TehoorMarjan/grannyclock/CAD/ClockV1/ClockV1Box.FCStd

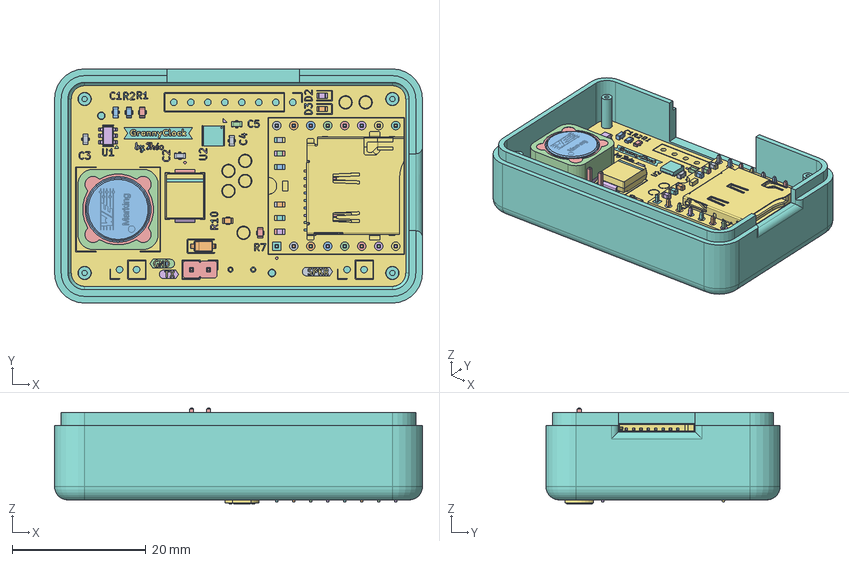
[picture p9: CAD file, 2025-05-12]
CAD/ClockV1/ClockV1Box.FCStd
55.0 x 35.0 x 14.3 mm
C_0603_1608Metric
LED_0603_1608Metric
R_0603_1608Metric
C_0603_1608Metric001
R_0603_1608Metric001
LED_0603_1608Metric001
DFR0299
DFR0300
DFR0301
DFR0302
DFR0303
DFR0304
DFR0305
DFR0306
DFR0307
DFR0308
DFR0309
DFR0310
DFR0311
DFR0312
DFR0313
DFR0314
DFR0315
DFR0316
DFR0317
DFR0318
DFR0319
DFR0320
DFR0321
DFR0322
DFR0323
DFR0324
DFR0325
DFR0326
DFR0327
DFR0328
DFR0329
DFR0330
DFR0331
DFR0332
DFR0333
DFR0334
DFR0335
DFR0336
DFR0337
DFR0338
DFR0339
DFR0340
DFR0341
DFR0342
DFR0343
DFR0344
DFR0345
DFR0346
DFR0347
DFR0348
DFR0349
DFR0350
DFR0351
DFR0352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
