TehoorMarjan/grannyclock/CAD/DualAABatteryBox/DualAABatteryBox.step

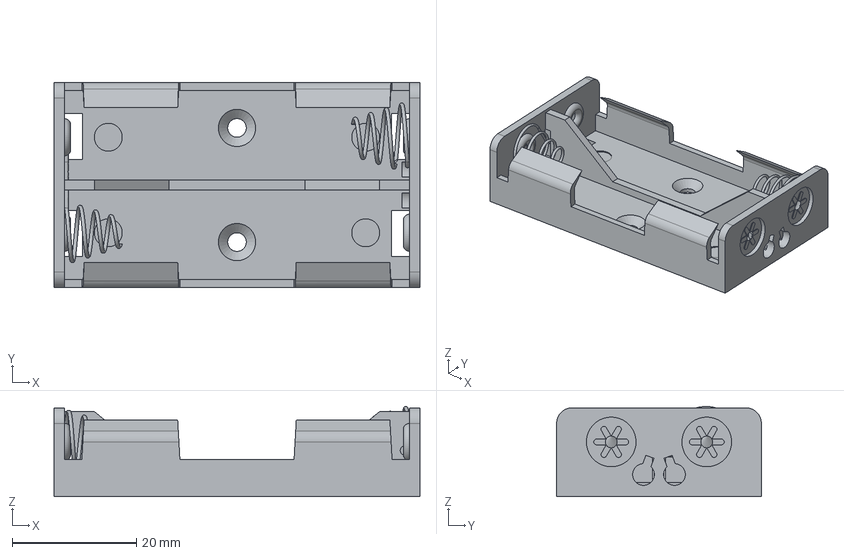
[picture p10: CAD file, 2025-05-19]
CAD/DualAABatteryBox/DualAABatteryBox.step
59.0 x 33.0 x 14.5 mm
