TehoorMarjan/grannyclock/CAD/HD-1688_Inner/HD-1688_Inner.step

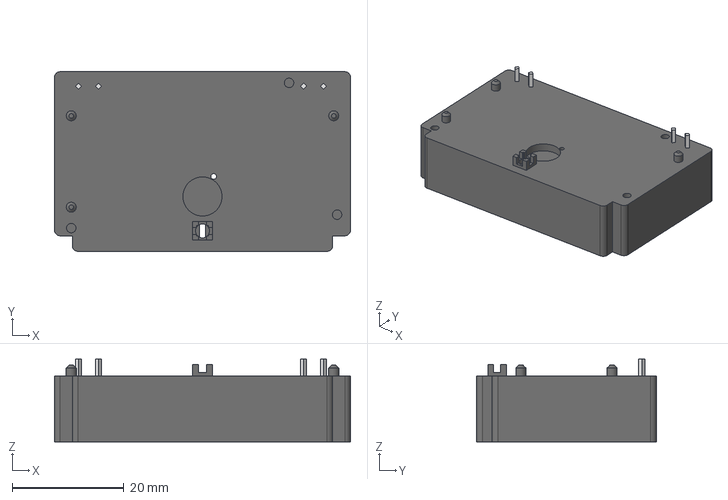
[picture p11: CAD file, 2025-05-23]
CAD/HD-1688_Inner/HD-1688_Inner.step
53.0 x 32.2 x 14.8 mm
Pins
