TehoorMarjan/grannyclock/CAD/TFA_Dostmann_60_3518_01/TFA_Dostmann_60_3518_01.step

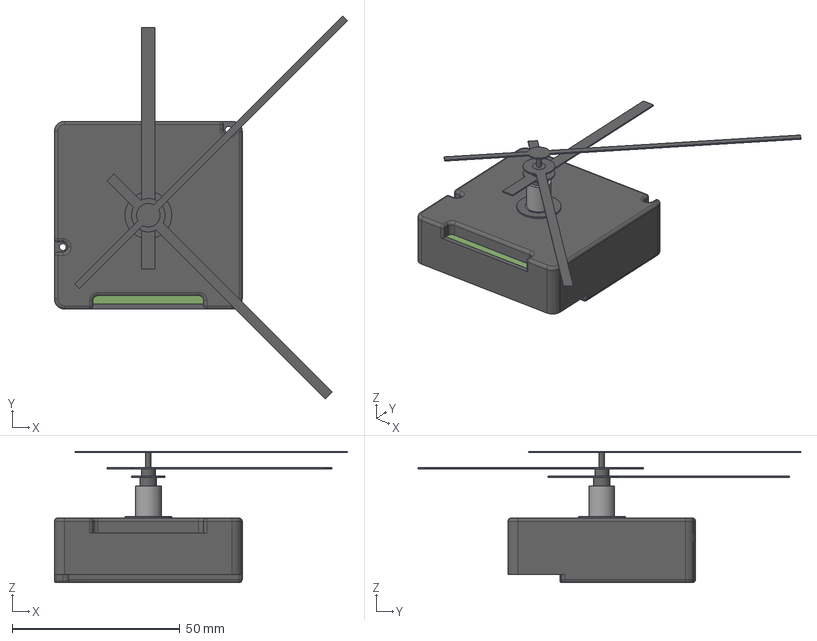
[picture p12: CAD file, 2025-05-19]
CAD/TFA_Dostmann_60_3518_01/TFA_Dostmann_60_3518_01.step
87.4 x 114.2 x 39.2 mm
Case
PCB
Axle
HandAxle
HourHand
MinuteHand
SecondHand
