TehoorMarjan/grannyclock/(list of files, cad)

Other CAD files:
CAD/HD-1688_Inner/HD-1688_Inner.FCStd
CAD/TFA_Dostmann_60_3518_01/TFA_Dostmann_60_3518_01.FCStd
