TehoorMarjan/grannyclock/Testing/ATtiny1616Boilerplate/circuit/ATtiny1616Boilerplate_sch.png

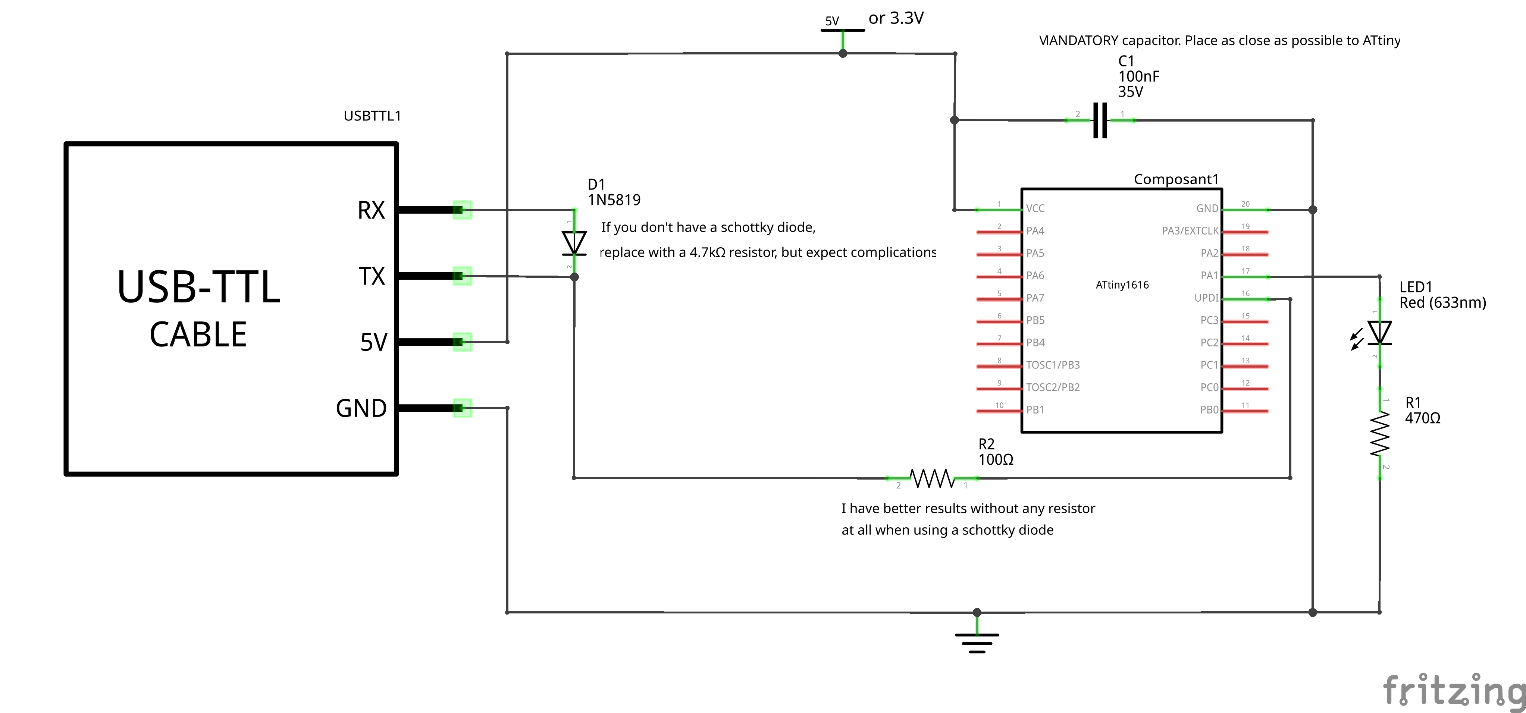
Testing/ATtiny1616Boilerplate/circuit/ATtiny1616Boilerplate_sch.png
