TehoorMarjan/grannyclock/Testing/DRV8833DFPlayer/circuit/DRV8833_sch.png

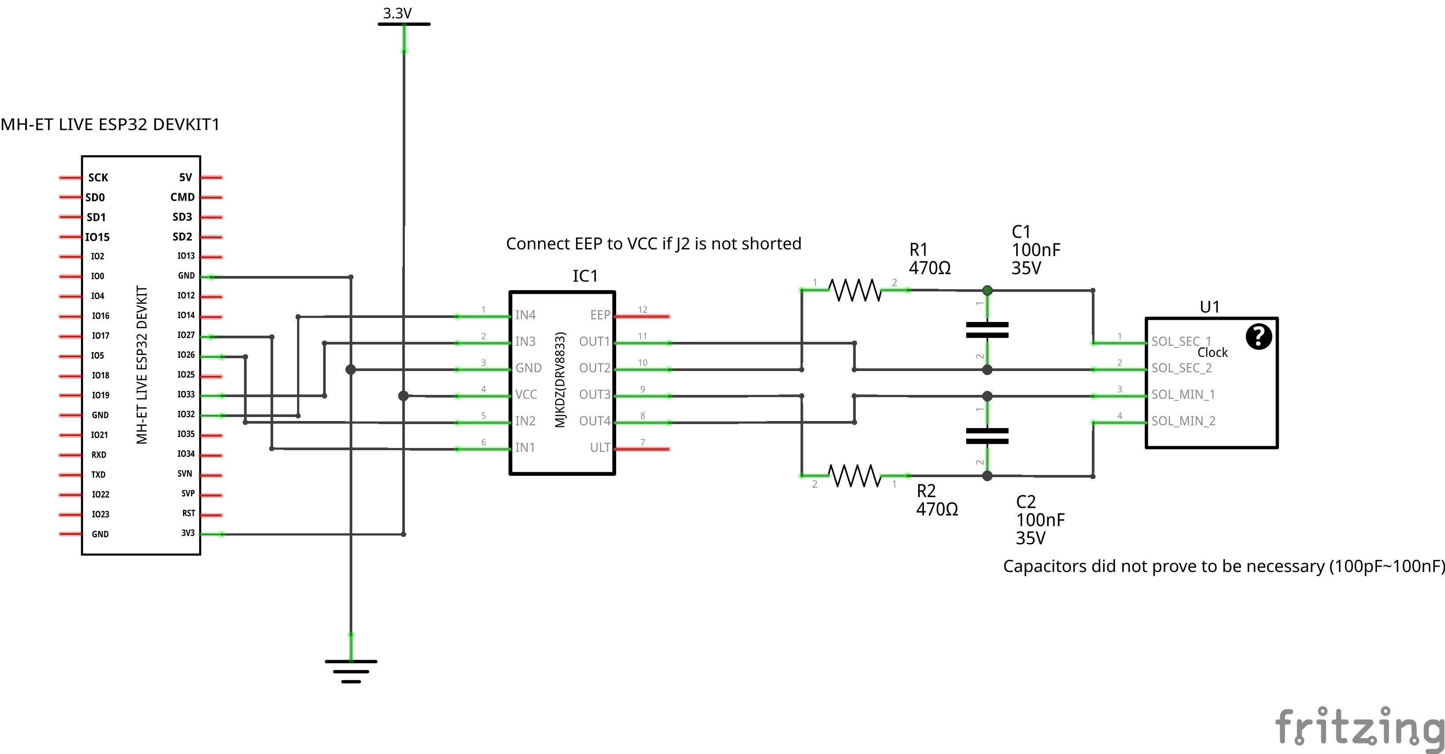
Testing/DRV8833DFPlayer/circuit/DRV8833_sch.png
