TehoorMarjan/grannyclock/Testing/Sniffer/circuit/Sniffer_sch.png

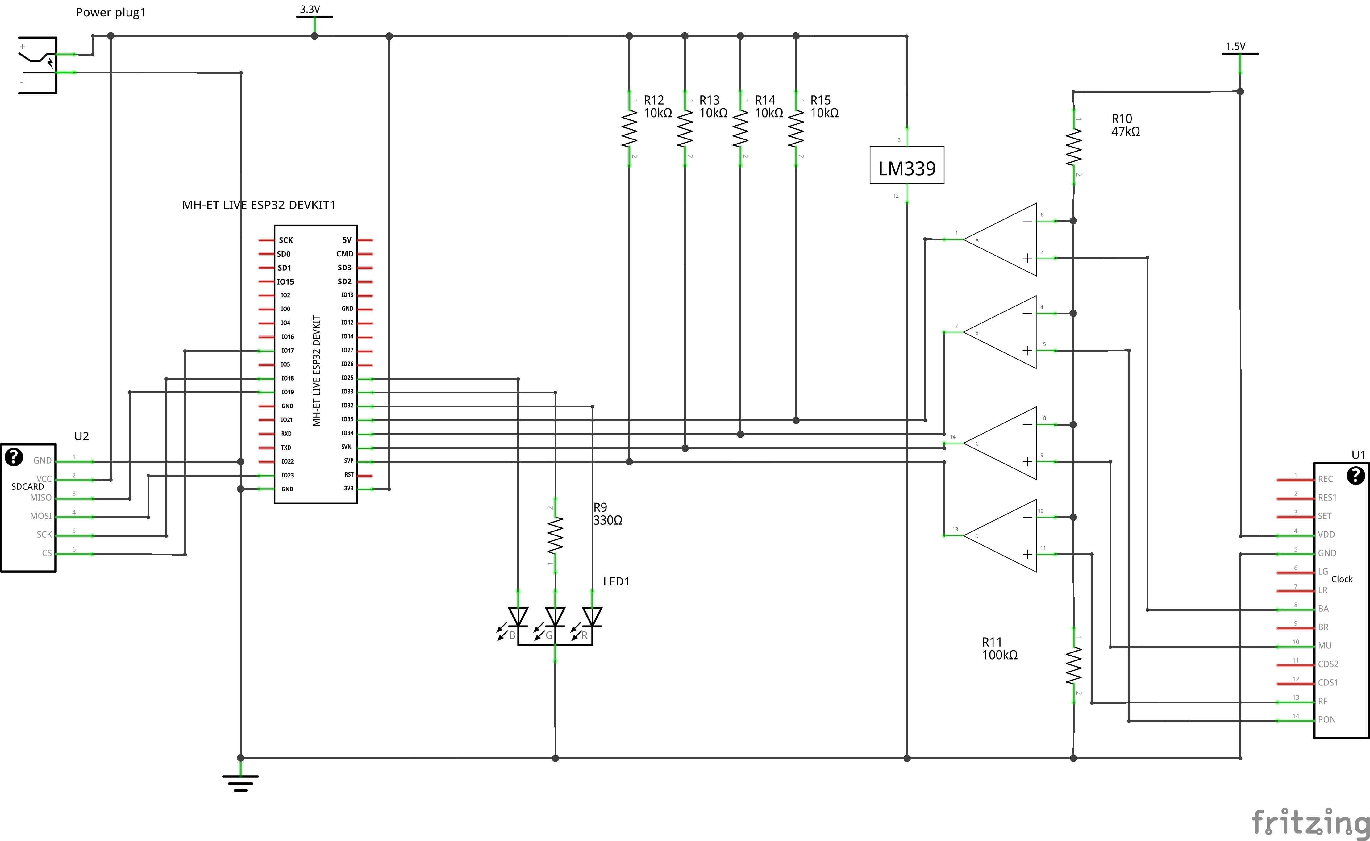
Testing/Sniffer/circuit/Sniffer_sch.png
