TehoorMarjan/grannyclock/PCB/ClockV1/output/schematics/ClockV1.pdf

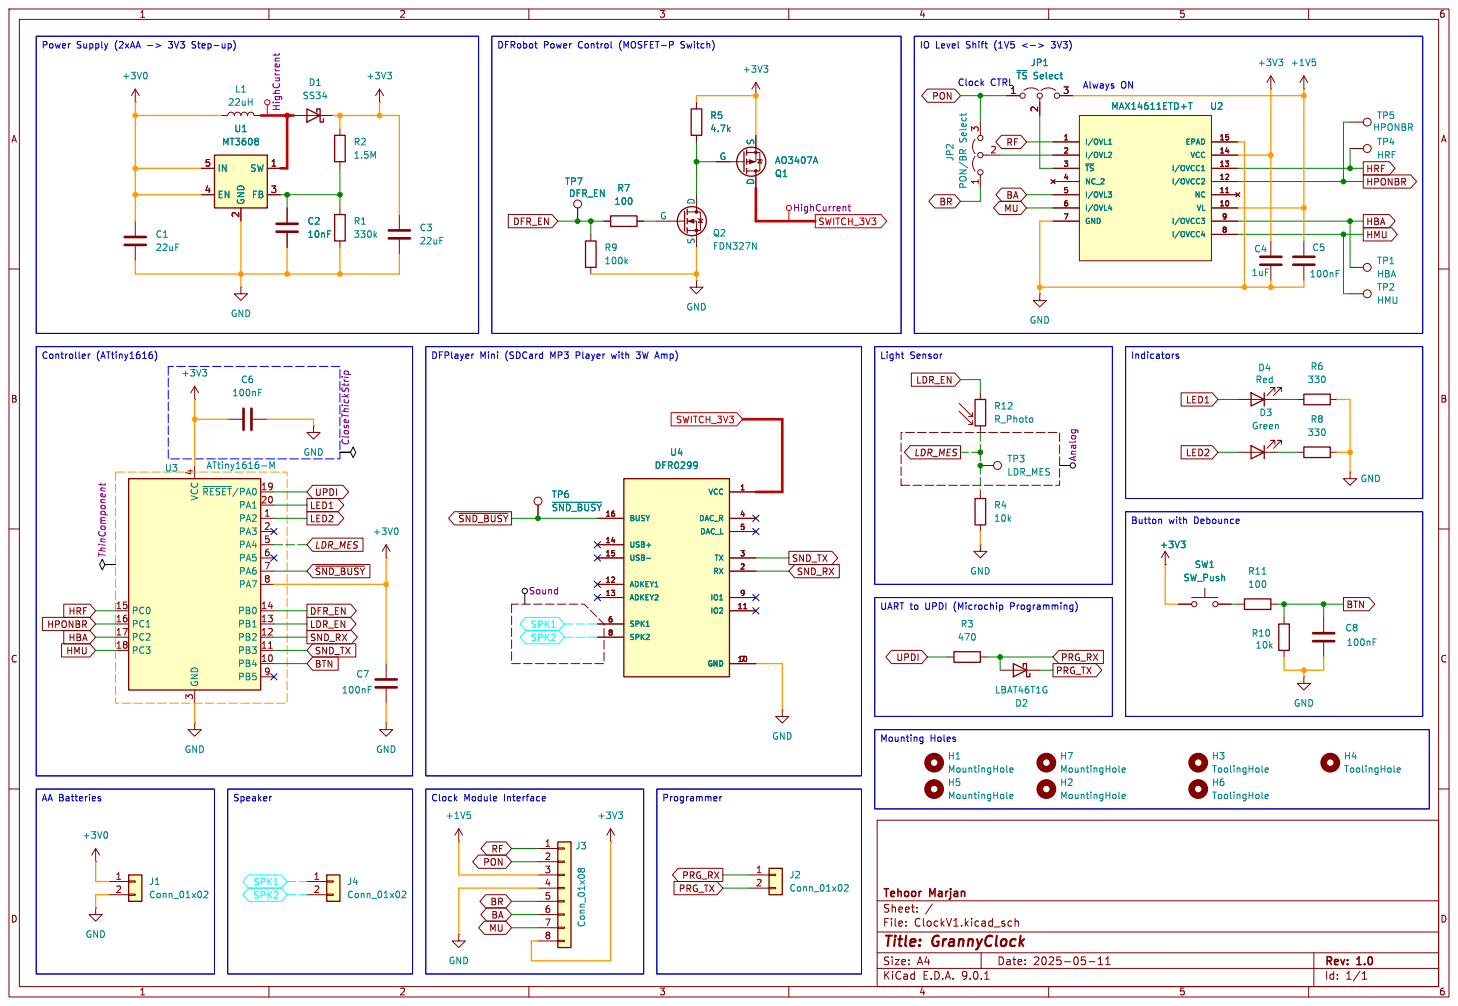
[picture p16: page 1]

DFRobot Power Control (MOSFET-P Switch)
