TehoorMarjan/grannyclock/CAD/ClockV1/ClockV1.pdf

A

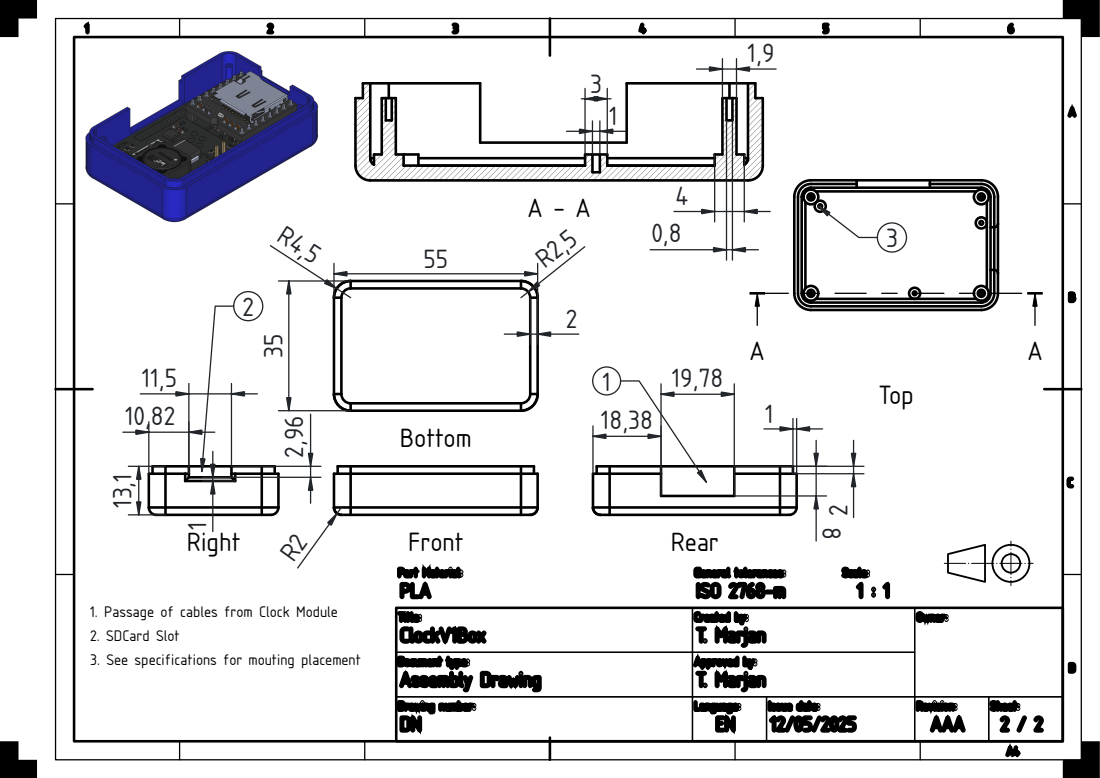
[picture p17: page 1]
Fro; Bottom ³⁵; 2 19,78 18,38 1 Right ¹³,1; 2 1. Passage of cables from Clock Module 2. SDCard Slot 3. See specifications for mouting placement
