TehoorMarjan/grannyclock/(list of files, drawings)

Other design files:
Testing/ATtiny1616Boilerplate/circuit/ATtiny1616Boilerplate.fzz
Testing/DRV8833DFPlayer/circuit/DRV8833.fzz
Testing/Sniffer/circuit/Sniffer.fzz
