TehoorMarjan/grannyclock/PCB/ClockV1/ClockV1.kicad_pcb

## KiCad design PCB/ClockV1/ClockV1.kicad_pcb (2025-05-25)

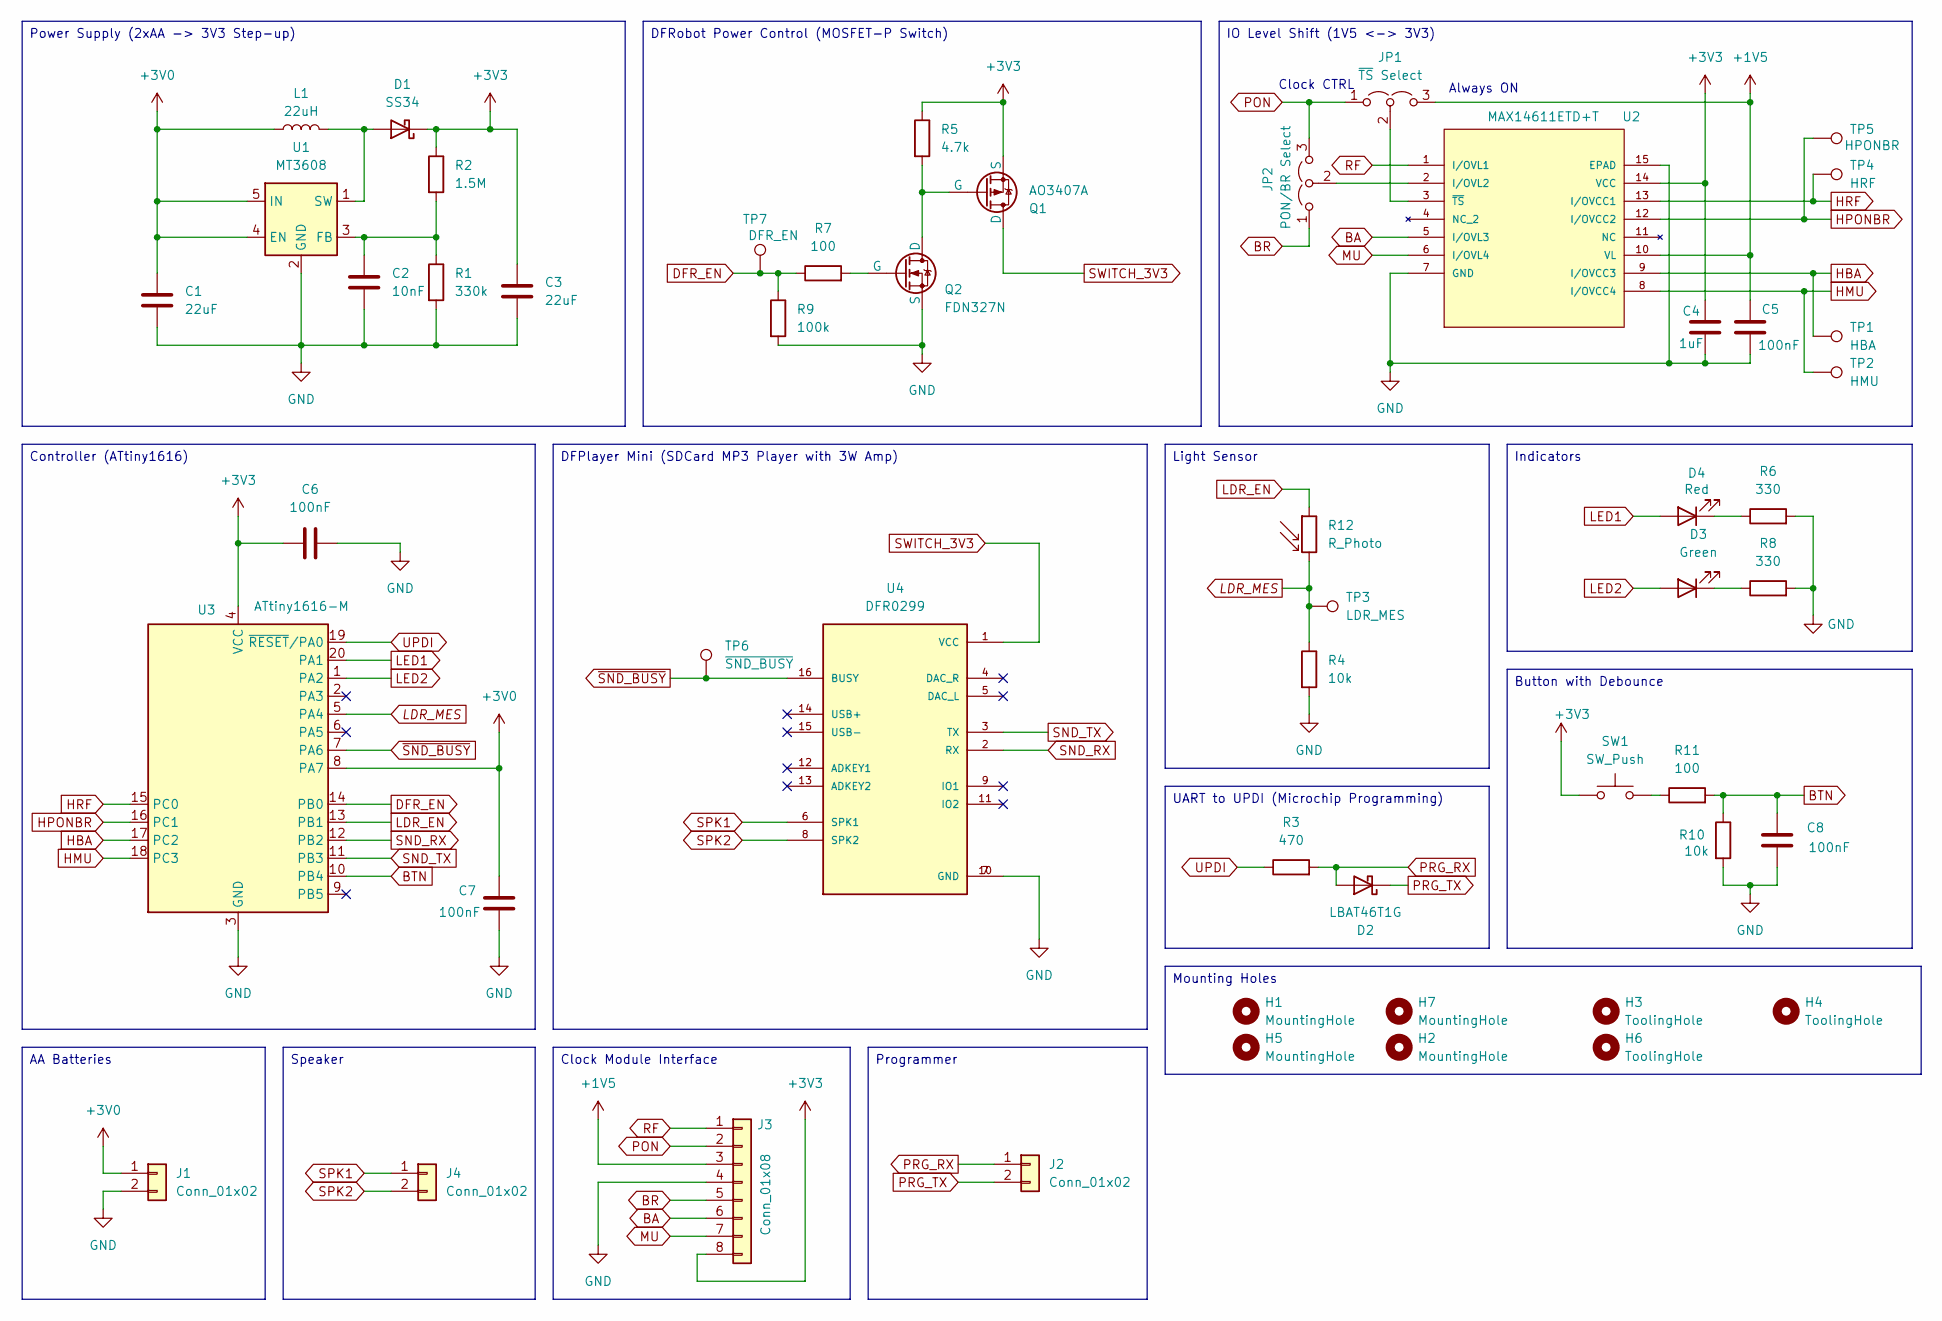
[picture p18: schematic ClockV1.kicad_sch, GrannyClock]

Parts:
C1, C3: 22uF; C_0603_1608Metric
C2: 10nF; C_0603_1608Metric
C4: 1uF; C_0603_1608Metric
C5, C6, C7, C8: 100nF; C_0603_1608Metric
D1: SS34; SS34_DIO_SS34
D2: LBAT46T1G; D_SOD-123
D3: Green; LED_0603_1608Metric
D4: Red; LED_0603_1608Metric
H1, H2, H5, H7: MountingHole; MountingHole_2mm
H3, H4, H6: ToolingHole; ToolingHole_1.152mm
J1, J2, J4: Conn_01x02; PinHeader_1x02_P2.54mm_Vertical
J3: Conn_01x08; PinHeader_1x08_P2.54mm_Vertical
JP1: ~{TS} Select; SolderJumper-3_P1.3mm_Open_RoundedPad1.0x1.5mm
JP2: PON/BR Select; SolderJumper-3_P1.3mm_Open_RoundedPad1.0x1.5mm
L1: 22uH; L_12x12mm_H4.5mm; MANUFACTURER_PART_NUMBER SDRH.1209CT.NLF220MT00; JLCPCB Part # C5123081
Q1: AO3407A; SOT-23-3; Manufacturer_Part_Number AO3407A; JLCPCB Part # C5224209
Q2: FDN327N; FDN327N_SSOT-3
R1: 330k; R_0603_1608Metric
R2: 1.5M; R_0603_1608Metric
R3: 470; R_0603_1608Metric
R4, R10: 10k; R_0603_1608Metric
R5: 4.7k; R_0603_1608Metric
R6, R8: 330; R_0603_1608Metric
R7, R11: 100; R_0603_1608Metric
R9: 100k; R_0603_1608Metric
R12: R_Photo; R_LDR_4.9x4.2mm_P2.54mm_Vertical
SW1: SW_Push; SW_PUSH_1P1T_6x3.5mm_H4.3_APEM_MJTP1243
TP1: HBA; TestPoint_Pad_D1.5mm
TP2: HMU; TestPoint_Pad_D1.5mm
TP3: LDR_MES; TestPoint_Pad_D1.5mm
TP4: HRF; TestPoint_Pad_D1.5mm
TP5: HPONBR; TestPoint_Pad_D1.5mm
TP6: ~{SND_BUSY}; TestPoint_Pad_D1.5mm
TP7: DFR_EN; TestPoint_Pad_D1.5mm
U1: MT3608; SOT-23-6
U2: MAX14611ETD+T; TDFN-14-1EP_3x3mm_P0.4mm_EP1.78x2.35mm; MANUFACTURER_PART_NUMBER MAX14611ETD+; JLCPCB Part # C2677488
U3: ATtiny1616-M; VQFN-20-1EP_3x3mm_P0.4mm_EP1.7x1.7mm_ThermalVias
U4: DFR0299; DFR0299_MODULE_DFR0299

Connections:
+1V5: C5.1, J3.3, JP1.3 (B), U2.10 (VL)
+3V0: C1.1, C7.2, J1.1, L1.1, U1.4 (EN), U1.5 (IN), U3.8 (PA7)
+3V3: C3.1, C4.1, C6.1, D1.1 (K), J3.8, Q1.3 (S), R2.1, R5.1, SW1.1, U2.14 (VCC), U3.4 (VCC)
BA: J3.6, U2.5 (I/OVL3)
BR: J3.5, JP2.1 (A)
BTN: C8.1, R10.1, R11.2, U3.10 (PB4)
DFR_EN: R7.1, R9.1, TP7.1, U3.14 (PB0)
GND: C1.2, C2.2, C3.2, C4.2, C5.2, C6.2, C7.1, C8.2, J1.2, J3.4, Q2.3 (S), R1.2, R4.2, R6.2, R8.2, R9.2, R10.2, U1.2 (GND), U2.7 (GND), U2.15 (EPAD), U3.3 (GND), U3.21 (GND), U4.7 (GND), U4.10 (GND)
HBA: TP1.1, U2.9 (I/OVCC3), U3.17 (PC2)
HMU: TP2.1, U2.8 (I/OVCC4), U3.18 (PC3)
HPONBR: TP5.1, U2.12 (I/OVCC2), U3.16 (PC1)
HRF: TP4.1, U2.13 (I/OVCC1), U3.15 (PC0)
LDR_EN: R12.1, U3.13 (PB1)
LDR_MES: R4.1, R12.2, TP3.1, U3.5 (PA4)
LED1: D4.2 (A), U3.20 (PA1)
LED2: D3.2 (A), U3.1 (PA2)
MU: J3.7, U2.6 (I/OVL4)
unnamed: D1.2 (A), L1.2, U1.1 (SW)
unnamed: D3.1 (K), R8.1
unnamed: D4.1 (K), R6.1
unnamed: JP1.2 (C), U2.3 (~TS)
unnamed: JP2.2 (C), U2.2 (I/OVL2)
unnamed: Q1.2 (G), Q2.1 (D), R5.2
unnamed: Q2.2 (G), R7.2
unnamed: R11.1, SW1.2
unnamed: C2.1, R1.1, R2.2, U1.3 (FB)
PON: J3.2, JP1.1 (A), JP2.3 (B)
PRG_RX: D2.2 (A), J2.1, R3.2
PRG_TX: D2.1 (K), J2.2
RF: J3.1, U2.1 (I/OVL1)
SND_RX: U3.12 (PB2), U4.2 (RX)
SND_TX: U3.11 (PB3), U4.3 (TX)
SPK1: J4.1, U4.6 (SPK1)
SPK2: J4.2, U4.8 (SPK2)
SWITCH_3V3: Q1.1 (D), U4.1 (VCC)
UPDI: R3.1, U3.19 (~RESET/PA0)
~SND_BUSY: TP6.1, U3.7 (PA6), U4.16 (BUSY)

Notes on the sheet:
Clock CTRL
Always ON
DFRobot Power Control (MOSFET-P Switch)
Indicators
Clock Module Interface
Button with Debounce
Speaker
Mounting Holes
AA Batteries
Controller (ATtiny1616)
DFPlayer Mini (SDCard MP3 Player with 3W Amp)
IO Level Shift (1V5 <-> 3V3)
UART to UPDI (Microchip Programming)
Power Supply (2xAA -> 3V3 Step-up)
Light Sensor
Programmer

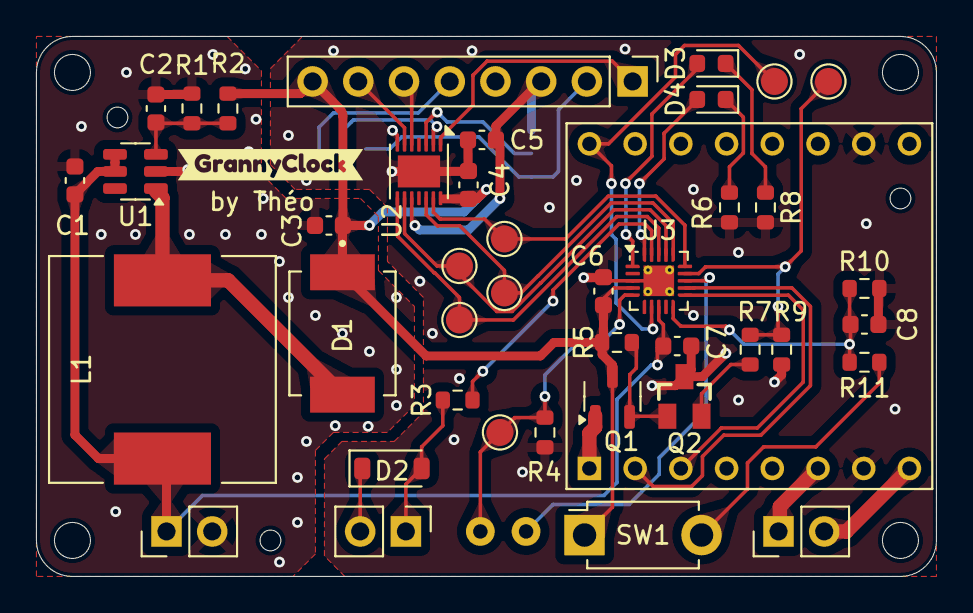
[picture p19: board ClockV1.kicad_pcb from above]

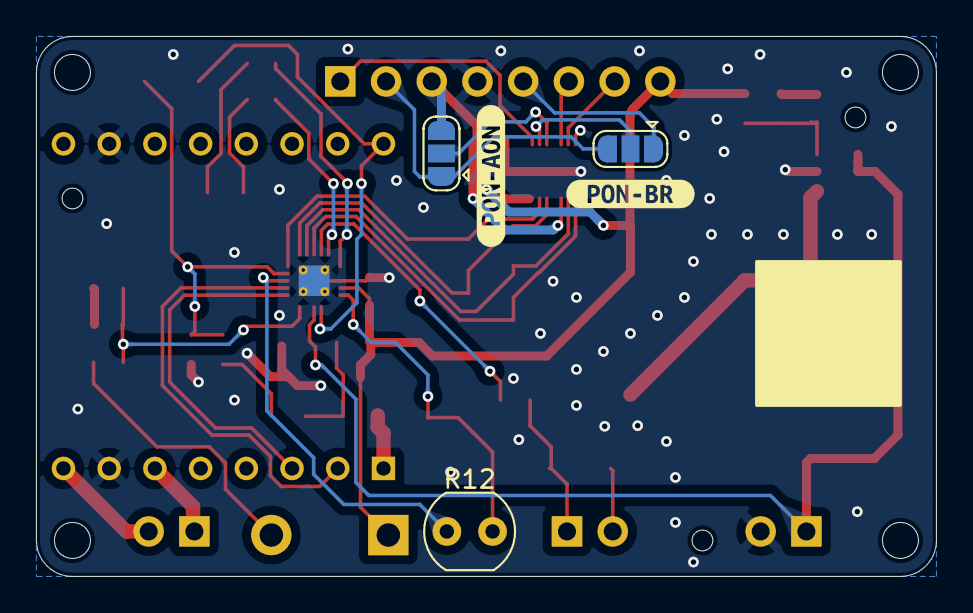
[picture p20: board ClockV1.kicad_pcb from below]

Board: 2 copper layers, 50.0 x 30.0 mm, 55 parts (5 on the bottom side), 37 nets.

Other parts of the board:
kibuzzard-1: G***; kibuzzard-681BEBFE
kibuzzard-2: G***; kibuzzard-681FCEAB
kibuzzard-3: G***; kibuzzard-681FCE61
