TehoorMarjan/grannyclock/(commit log)

2025-04-27 Add core functionality for signal logging and SD card management
    - Implemented RingBuffer class for event storage with thread safety.
    - Created SDCardManager class to handle SD card initialization and event saving.
    - Developed SignalLogger class to log RF signals and manage interrupts.
    - Added StatusIndicator class for visual feedback on system status.
    - Integrated all components in main application loop for signal monitoring and data saving.
    - Introduced CSV to VCD conversion script for data analysis.
    - Added Jupyter Notebook for signal analysis and pattern recognition.
    - Configured PlatformIO project settings for building and uploading to ESP32.
    [Sniffer.fzz]
2025-04-27 Fix image path for breadboard schematics in SPECS.md
2025-05-07 PCB Version 1
    [ClockV1.kicad_pcb, ClockV1.kicad_sch, ClockV1.step]
2025-05-09 Production to JLCPCB
    [ClockV1.kicad_pcb, ClockV1.kicad_sch, bom.csv, designators.csv, positions.csv]
2025-05-10 Add decoupling capacitors and signal selection jumper for MAX14611
    - Added decoupling capacitors (C5/100nF and C6/1uF) for the MAX14611 dual power supplies
    - Added solder jumper to allow selection between PON and BR signals for microcontroller input
    - Renamed net HBR to Net-(JP2-C) to better reflect its function as jumper connection
    - Added new HPONBR signal net for level shifter power control
    - Updated PCB date to 2025-05-11
    [ClockV1.kicad_pcb, ClockV1.kicad_sch, bom.csv, designators.csv, positions.csv]
2025-05-12 Update of PCB ClockV1
    - Export Silkscreen in 3D
    - Add jumper to select monitoring PON
    - Re-order references
    - Monitor +3V0 from uC with ADC and a decoupling capactior
    - Changed photoresistor footprint (actual part is smaller than expected)
    [ClockV1.kicad_pcb, ClockV1.kicad_sch, ClockV1.step, bom.csv, designators.csv, positions.csv]
2025-05-12 CAD: First try for a box
    [ClockV1Box.FCStd]
2025-05-14 Add switch to PCB
    - Added a single push button switch
    - Added RC filter for (pre-)debounce
    - Moved tooling hole to place the button
    - Removed some silkscreen labels to make room
    - Renumbered components depengind on their placement on the PCB
    [ClockV1.kicad_pcb, ClockV1.kicad_sch, bom.csv, designators.csv, positions.csv]
2025-05-15 Corrected debouncer
    - Capacitor was not positionned properly
    [ClockV1.kicad_pcb, ClockV1.kicad_sch, bom.csv, positions.csv]
2025-05-19 TFA Dostmann Clock Module (60.3518.01) 3D Model
    [TFA_Dostmann_60_3518_01.FCStd, TFA_Dostmann_60_3518_01.step, dimensions.csv]
2025-05-19 Add Dual AA Battery Holder modified CAD
    [DualAABatteryBox.step]
2025-05-19 Replace BR signal with PON, remove RF timing restrictions, and update hardware design
    This commit makes significant changes to the Clock Sniffer project:
    1. Replaced BR (BR signal) with PON (Power ON signal):
    - Updated pin definitions in Config.h
    - Modified signal type enums and string mappings
    - Updated interrupt handlers and signal processing code
    - Adapted csv2vcd.py to use PON in the WIRES list
    2. Removed RF signal logging time window restrictions:
    - Eliminated code for 5 min/30 min RF logging cycle
    - Removed timing constants for RF_ACTIVE_PERIOD and RF_INACTIVE_PERIOD
    - Modified SignalLogger to continuously monitor all signals
    - Simplified main loop SD card wri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
    [Sniffer.fzz]
2025-05-23 Add HD-1688 clock mechanism model and documentation
    Adds complete modeling of the Sheng Bang HD-1688MRC inner clock mechanism with:
    - 3D model files (FCStd, STEP)
    - Dimensional reference (CSV)
    - Visual preview (PNG)
    - Comprehensive README with project context and copyright disclaimer
    - CC BY-NC-SA license
    This model provides precise measurements for PCB design as part of the
    musical/talking clock project.
    [HD-1688_Inner.FCStd, HD-1688_Inner.csv, HD-1688_Inner.step]
2025-05-23 Enhance csv2vcd.py to handle timestamp resets
    - Added timestamp reset detection (ESP32 reboots or overflows)
    - Automatically splits output into multiple VCD files when resets occur
    - Uses sequential naming convention: output.vcd, output_1.vcd, etc.
    - Updated README with usage information for this feature
2025-05-25 Moved Sniffer to Testing/Sniffer
    [Sniffer.fzz]
2025-05-25 Store last changes in ClockV1 before deprecating
    [ClockV1.kicad_pcb, ClockV1.kicad_sch]
2025-05-26 Add DRV8833 solenoid driver test project
    This commit adds a complete test project for driving clock solenoids using the DRV8833 motor driver:
    Hardware components:
    - DRV8833 dual H-bridge motor driver (used for solenoid control)
    - ESP32 microcontroller
    - Clock solenoids (seconds and minutes hands)
    - 470 ohm resistors for current limiting
    Implementation details:
    - Control seconds solenoid using GPIO 27/26 (SOLENOID_SEC_1/SOLENOID_SEC_2)
    - Control minutes solenoid using GPIO 33/32 (SOLENOID_MIN_1/SOLENOID_MIN_2)
    - Configurable pulse width (optimal: 40ms)
    - Alternating control signals for proper solenoid activation
    Documentation:
    - Comprehensive README with project overview and experimental f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
    [DRV8833.fzz]
2025-05-27 Add ATtiny1616Boilerplate project with UPDI programming
    This commit introduces a complete boilerplate project for ATtiny1616 development:
    - Source code: Simple LED blink example on pin PA1
    - PlatformIO configuration: Setup for atmelmegaavr platform with UPDI programming
    - Circuit diagrams: Schematic and breadboard layouts showing proper UPDI connections
    - Auto-dependency installation: Script for automatic pymcuprog installation
    - Comprehensive documentation: Detailed README with hardware setup and programming guidelines
    The project demonstrates the recommended approach for reliable UPDI programming
    using a Schottky diode between RX and TX-UPDI lines, which provides more
    consistent results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
    [ATtiny1616Boilerplate.fzz]
